AlfredRod02/MONARQ-S-XVI/README.md

# MONARQ-S-XVI
A continuacion se muestran los archivos necesarios para poder replicar el proyecto de monitoreo de datos en edificiaciones historicas.
El archivo con la extension ".pdsprj" es el archivo realizado en isis de proteus, ahi se puede modificar el circuito a las necesidades del cliente.
Y el archivo en pdf del circuito esta en el archivo "PROYECTO_PCB" listo para ir a imprimirse y realizar la placa nuevamente.
