AlfredRod02/MONARQ-S-XVI/PROYECTO_PCB.pdf

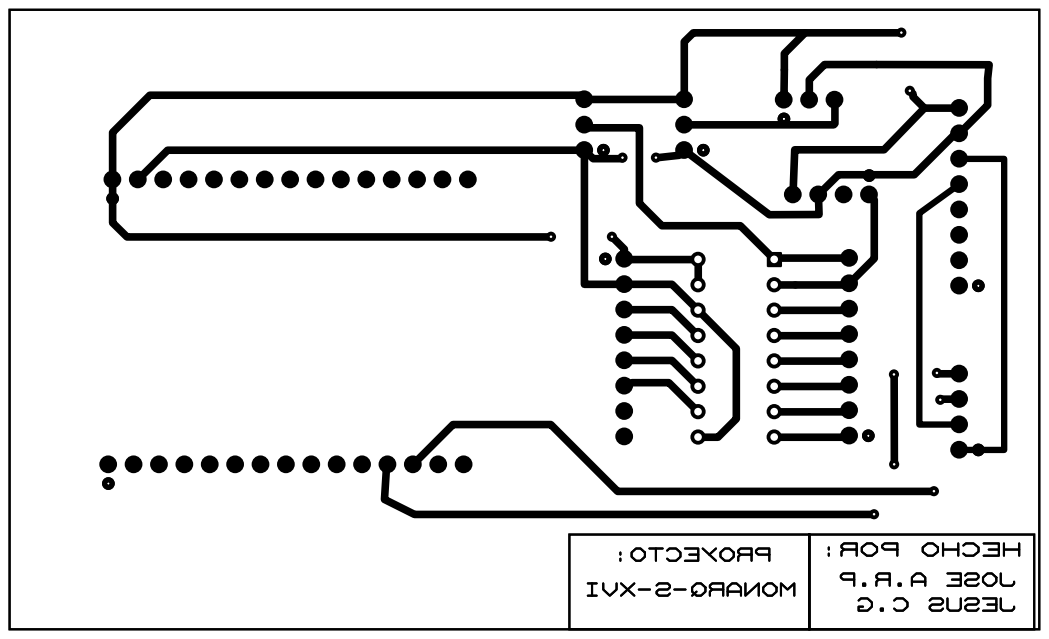
[picture p1: page 1]
