AlfredRod02/MONARQ-S-XVI/(list of files, drawings)

Other design files:
PROYECTO_DELFIN.pdsprj
